masto/NABU-USB-Converter/hardware/render.jpg

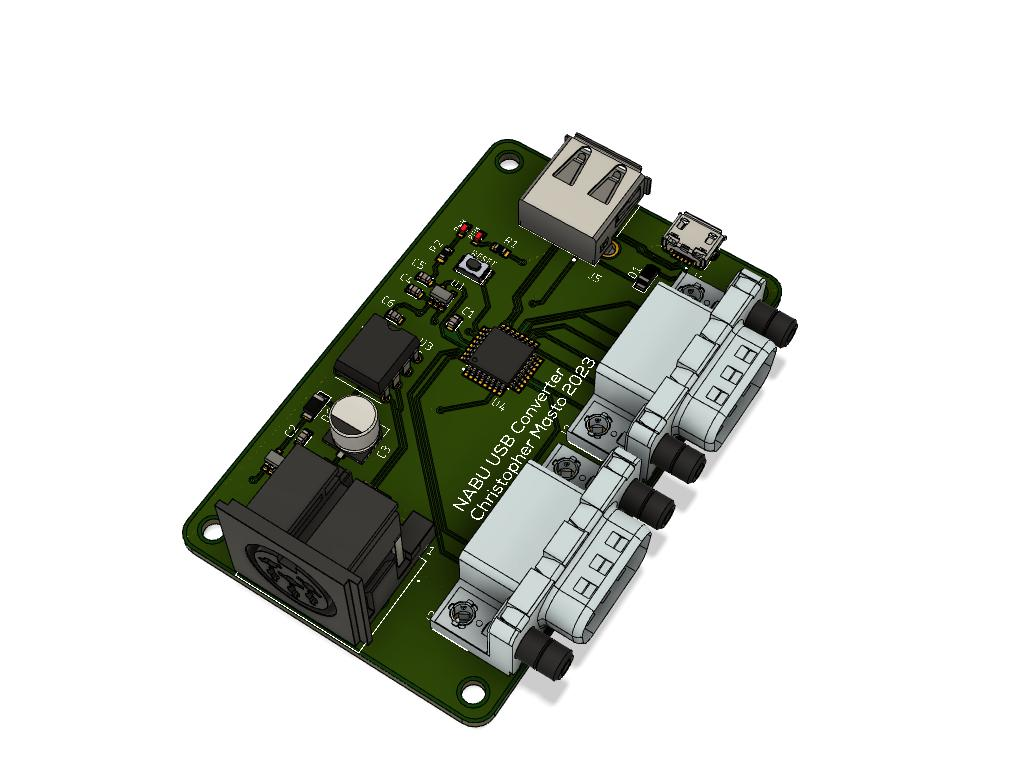
hardware/render.jpg
