masto/NABU-USB-Converter/README.md

# NABU-USB-Converter

Adapter to use a USB keyboard with the NABU PC
