masto/NABU-USB-Converter/hardware/enclosure/Bottom.3mf

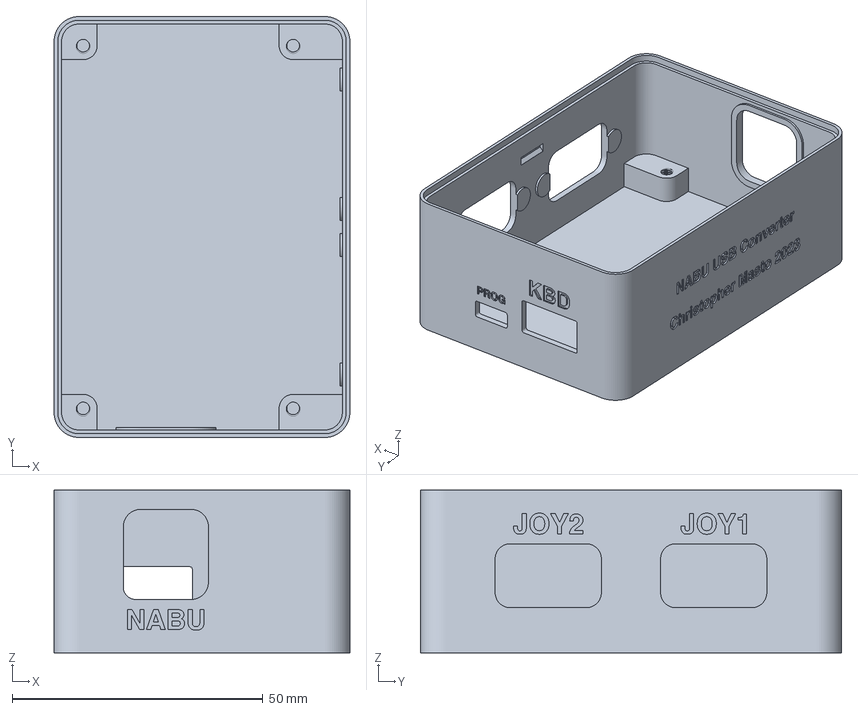
[picture p2: CAD file, 2023-05-16]
hardware/enclosure/Bottom.3mf
59.0 x 84.0 x 32.5 mm
