masto/NABU-USB-Converter/hardware/enclosure/Top.3mf

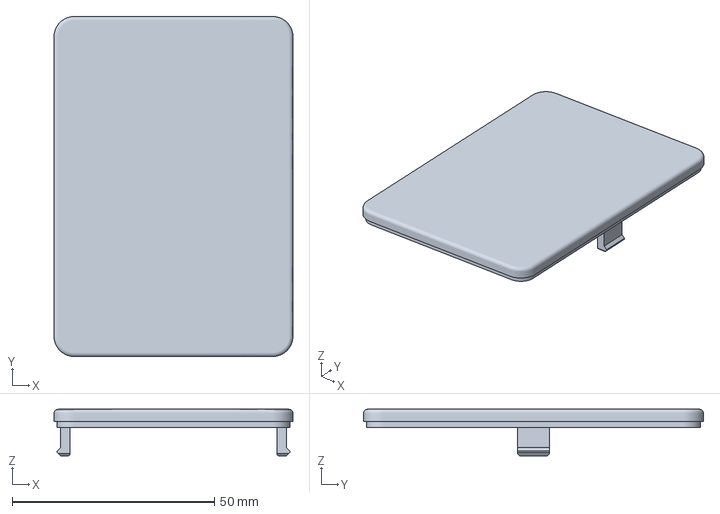
[picture p3: CAD file, 2023-05-16]
hardware/enclosure/Top.3mf
59.0 x 84.0 x 11.5 mm
