masto/NABU-USB-Converter/(list of files, cad)

Other CAD files:
hardware/enclosure/Enclosure.f3d
