masto/NABU-USB-Converter/hardware/board.pdf

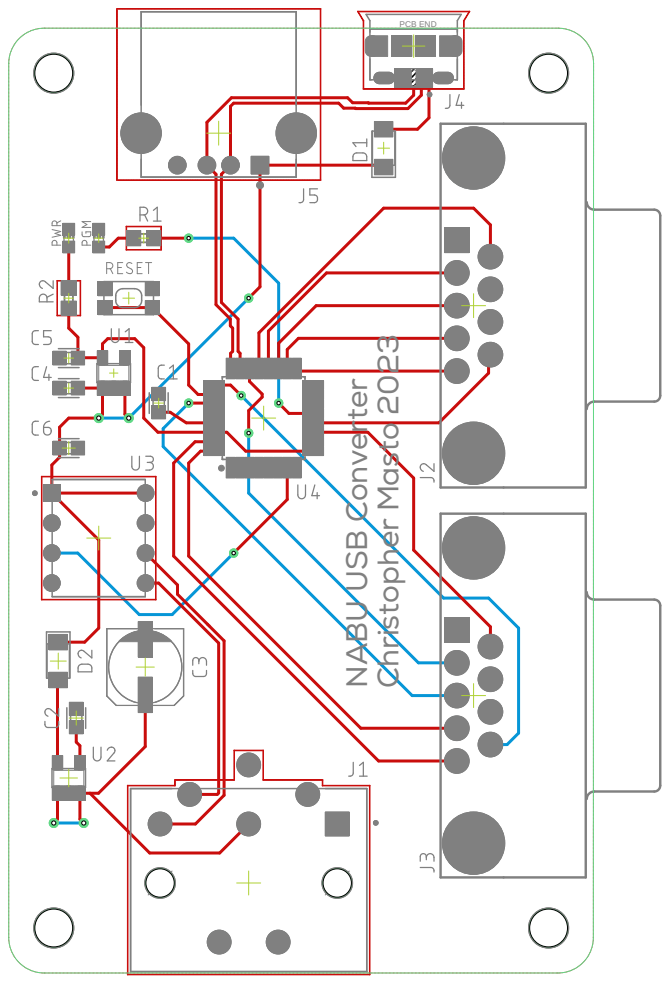
[picture p4: page 1]
