masto/NABU-USB-Converter/hardware/board/USB_to_NABU_Converter_v37.brd

## EAGLE design hardware/board/USB_to_NABU_Converter_v37.brd (2023-05-16)

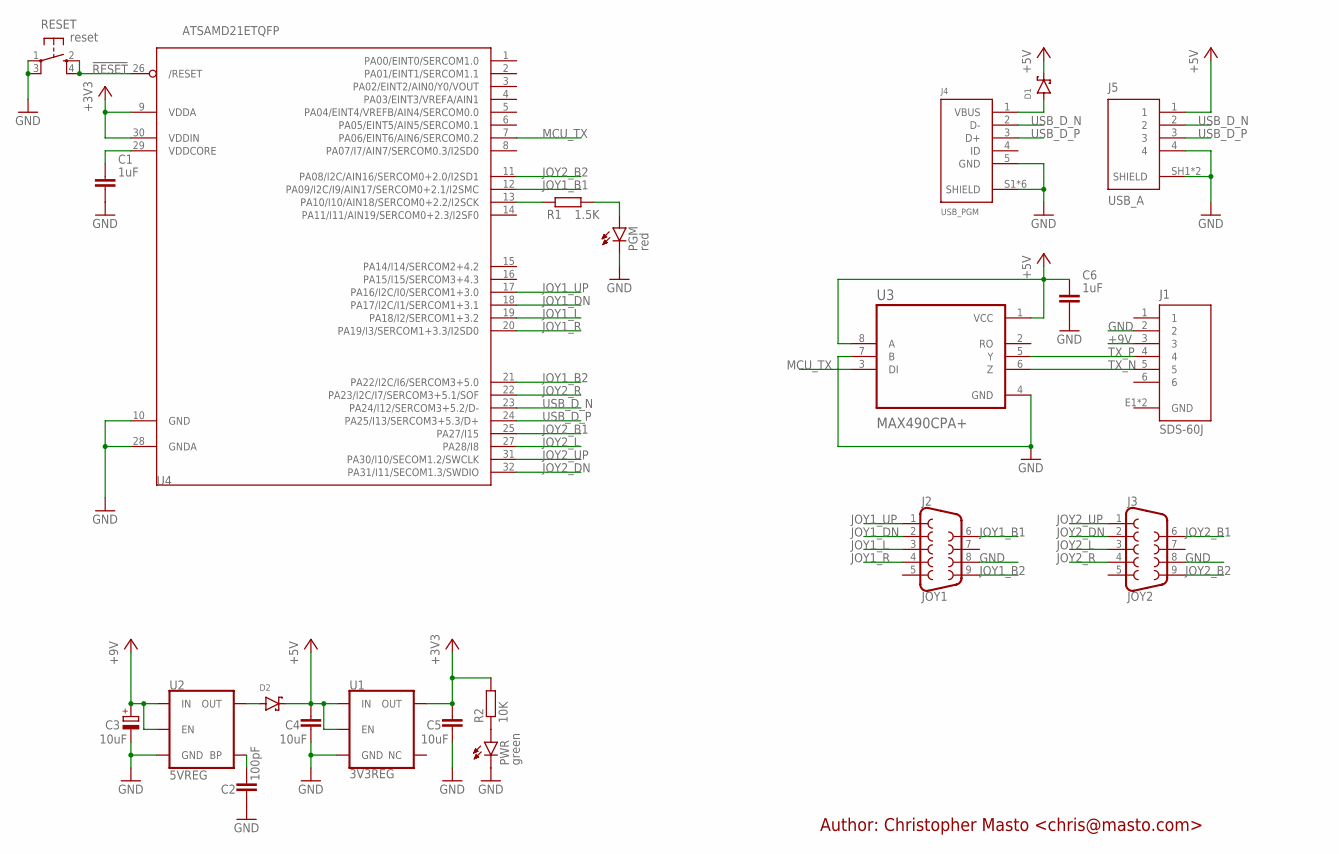
[picture p6: schematic USB_to_NABU_Converter_v37.sch]

Parts:
C1, C6: 1uF; CAPC1608X85
C2: 100pF; CAPC1608X85
C3: 10uF; UD-6,3X5,8_NICHICON
C4, C5: 10uF; CAPC1608X85
D1, D2: MBR0520LT1G; SODFL3718X115
J1: SDS-60J; CUI_SDS-60J
J2: JOY1; DB9_MALE
J3: JOY2; DB9_MALE
J4: USB_PGM; AMPHENOL_10118194-0001LF
J5: USB_A; 292303-1
PGM: red; CHIP-LED0603
PWR: green; CHIP-LED0603
R1: 1.5K; R0603
R2: 10K; R0603
RESET: reset; KMR2
U1: 3V3REG; SOT23-5
U2: 5VREG; SOT23-5
U3: MAX490CPA+; DIP794W47P254L991H457Q8
U4: ATSAMD21ETQFP; QFP80P900X900X120-32

Connections:
!RESET: RESET.2 (S), RESET.4 (S1), U4.26 (/RESET)
+3V3: C5.1, R2.2, U1.5 (OUT), U4.9 (VDDA), U4.30 (VDDIN)
+5V: C4.1, C6.1, D1.1 (C), D2.1 (C), J5.1, U1.1 (IN), U1.3 (EN), U3.1 (VCC), U3.8 (A)
+9V: C3.+, J1.3, U2.1 (IN), U2.3 (EN)
GND: C1.2, C2.2, C3.-, C4.2, C5.2, C6.2, J1.2, J1.E1 (GND), J1.E2 (GND), J2.8, J3.8, J4.5 (GND), J4.S1 (SHIELD), J4.S2 (SHIELD), J4.S3 (SHIELD), J4.S4 (SHIELD), J4.S5 (SHIELD), J4.S6 (SHIELD), J5.4, J5.SH1 (SHIELD), J5.SH2 (SHIELD), PGM.C, PWR.C, RESET.1, RESET.3 (P1), U1.2 (GND), U2.2 (GND), U3.4 (GND), U3.7 (B), U4.10 (GND), U4.28 (GNDA)
JOY1_B1: J2.6, U4.12 (PA09/I2C/I9/AIN17/SERCOM0+2.1/I2SMC)
JOY1_B2: J2.9, U4.21 (PA22/I2C/I6/SERCOM3+5.0)
JOY1_DN: J2.2, U4.18 (PA17/I2C/I1/SERCOM1+3.1)
JOY1_L: J2.3, U4.19 (PA18/I2/SERCOM1+3.2)
JOY1_R: J2.4, U4.20 (PA19/I3/SERCOM1+3.3/I2SD0)
JOY1_UP: J2.1, U4.17 (PA16/I2C/I0/SERCOM1+3.0)
JOY2_B1: J3.6, U4.25 (PA27/I15)
JOY2_B2: J3.9, U4.11 (PA08/I2C/AIN16/SERCOM0+2.0/I2SD1)
JOY2_DN: J3.2, U4.32 (PA31/I11/SECOM1.3/SWDIO)
JOY2_L: J3.3, U4.27 (PA28/I8)
JOY2_R: J3.4, U4.22 (PA23/I2C/I7/SERCOM3+5.1/SOF)
JOY2_UP: J3.1, U4.31 (PA30/I10/SECOM1.2/SWCLK)
MCU_TX: U3.3 (DI), U4.7 (PA06/EINT6/AIN6/SERCOM0.2)
unnamed: PWR.A, R2.1
unnamed: C1.1, U4.29 (VDDCORE)
unnamed: R1.1, U4.13 (PA10/I10/AIN18/SERCOM0+2.2/I2SCK)
unnamed: PGM.A, R1.2
unnamed: C2.1, U2.4 (BP)
unnamed: D1.2 (A), J4.1 (VBUS)
unnamed: D2.2 (A), U2.5 (OUT)
TX_N: J1.5, U3.6 (Z)
TX_P: J1.4, U3.5 (Y)
USB_D_N: J4.2 (D-), J5.2, U4.23 (PA24/I12/SERCOM3+5.2/D-)
USB_D_P: J4.3 (D+), J5.3, U4.24 (PA25/I13/SERCOM3+5.3/D+)

Notes on the sheet:
Author: Christopher Masto <chris@masto.com>

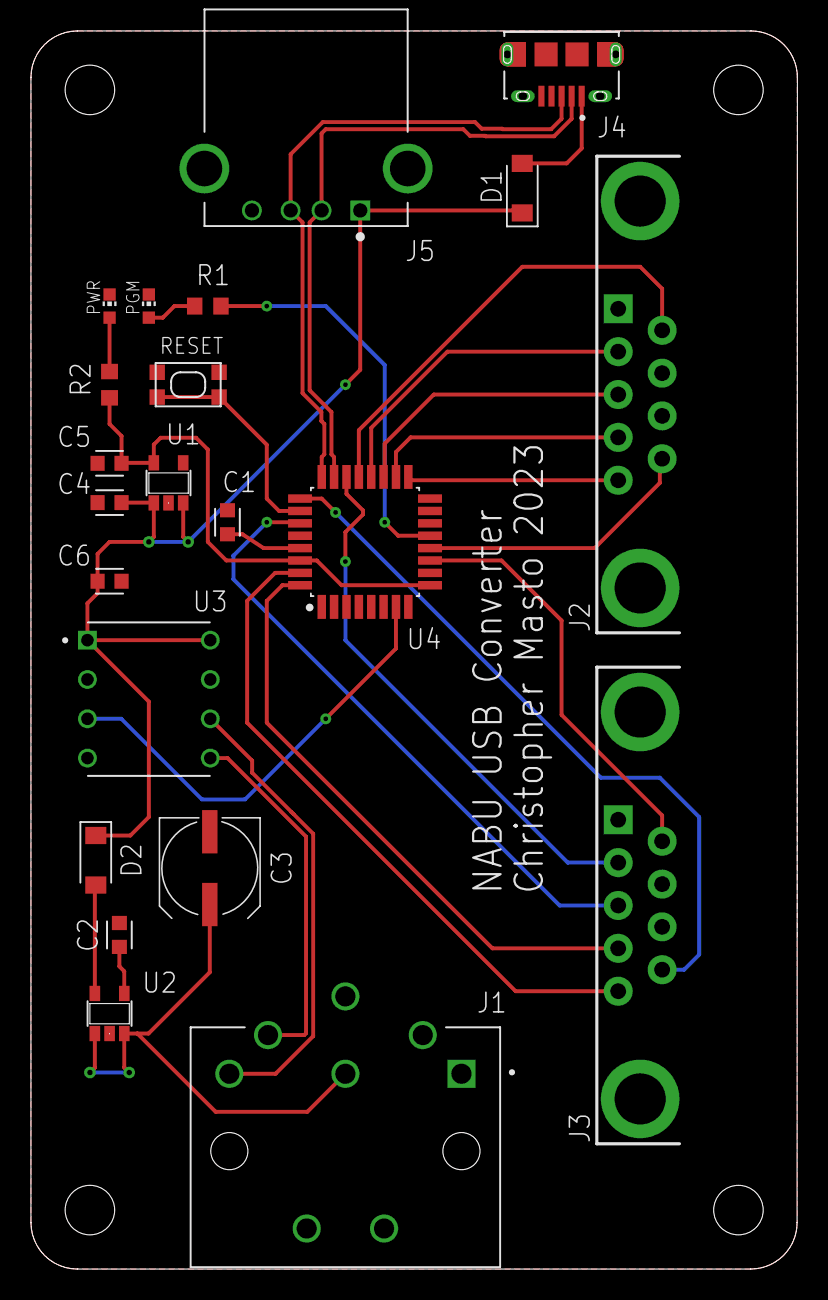
[picture p7: board USB_to_NABU_Converter_v37.brd from above]

Board: 2 copper layers, 49.5 x 80.0 mm, 22 parts (0 on the bottom side), 29 nets.
