masto/NABU-USB-Converter/(commit log)

2023-05-10 Create an Arduino variant for our board
    This is initially a straight copy of trinket_m0, and will now be
    modified to enable and rename the I/O pins.
    [nabu_usb.cfg]
2023-05-11 Reformat
    Since VS Code is going to reformat these files when I save them,
    I am doing a preemptive reformat before committing any actual code
    changes, in order to avoid mixing them. You're welcome.
    [variant.cpp, variant.h]
2023-05-11 Add remaining pin assignments
    I don't know if they're going to work or not...
2023-05-13 Fix some bad copy/paste
    [variant.cpp]
2023-05-16 Add enclosure models and 3D printing files
    [Bottom.3mf, Enclosure.f3d, Top.3mf]
2023-05-16 Add electronics design files
    [USB_to_NABU_Converter_v37.brd, USB_to_NABU_Converter_v37.sch]
2023-05-19 Support alternate serial port for debugging
    This adds the ability to attach a TTL serial interface on JOY2.
    I was going to use this to output debug logs without interfering with
    the NABU interface, but have decided to take a different approach.
    It's still useful to have these pins defined, though. It should have
    no effect if not used.
    [variant.cpp, variant.h]
